alexj0i/capteur-qualite-air/docs/photos/README.md

# Photos

Photos du montage réel : composants, câblage, appareil assemblé.
Pour les afficher dans le README principal : `![Description](docs/photos/nom-du-fichier.jpg)`.
