alexj0i/capteur-qualite-air/docs/ecran/07_ota.png

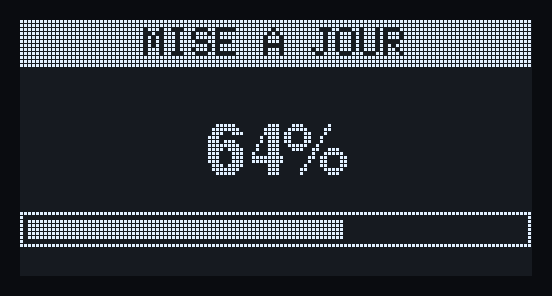
docs/ecran/07_ota.png
