alexj0i/capteur-qualite-air/docs/ecran/apercu.png

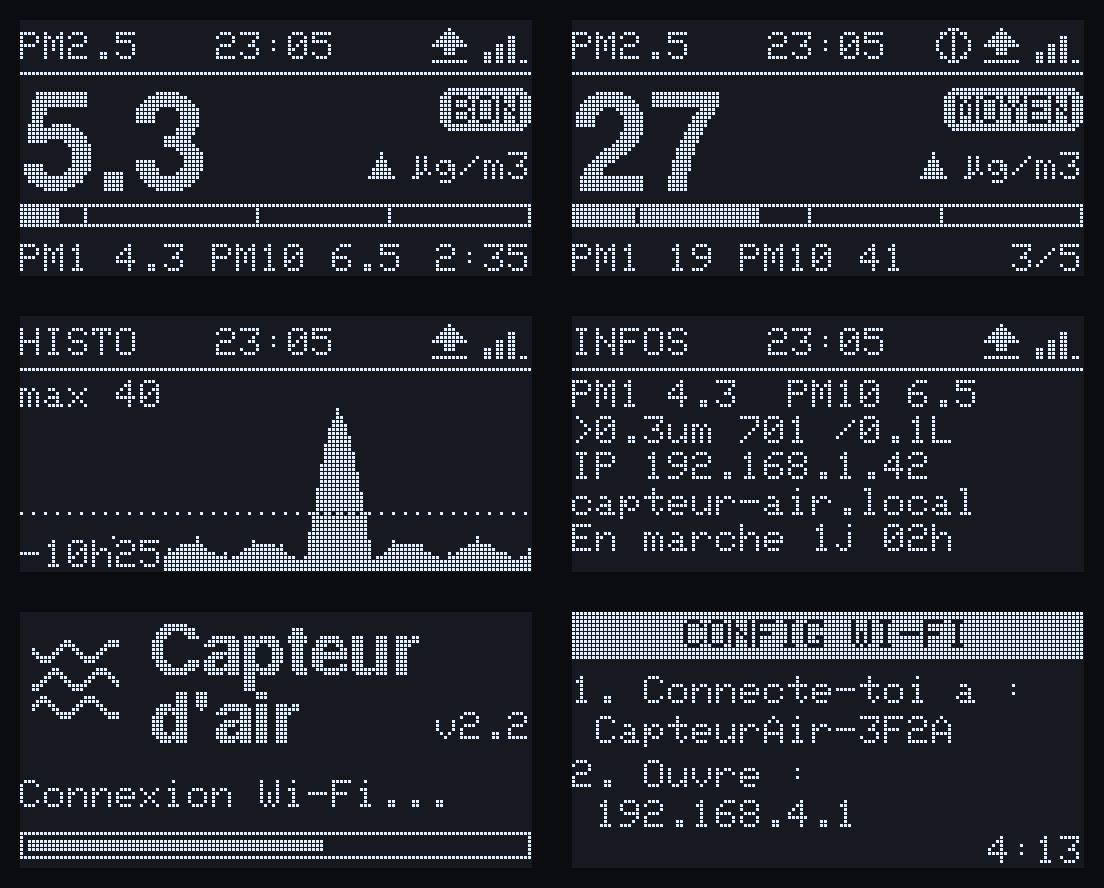
docs/ecran/apercu.png
